aMarkusa/Lab-bench-power-supply/Design files/schematic.pdf

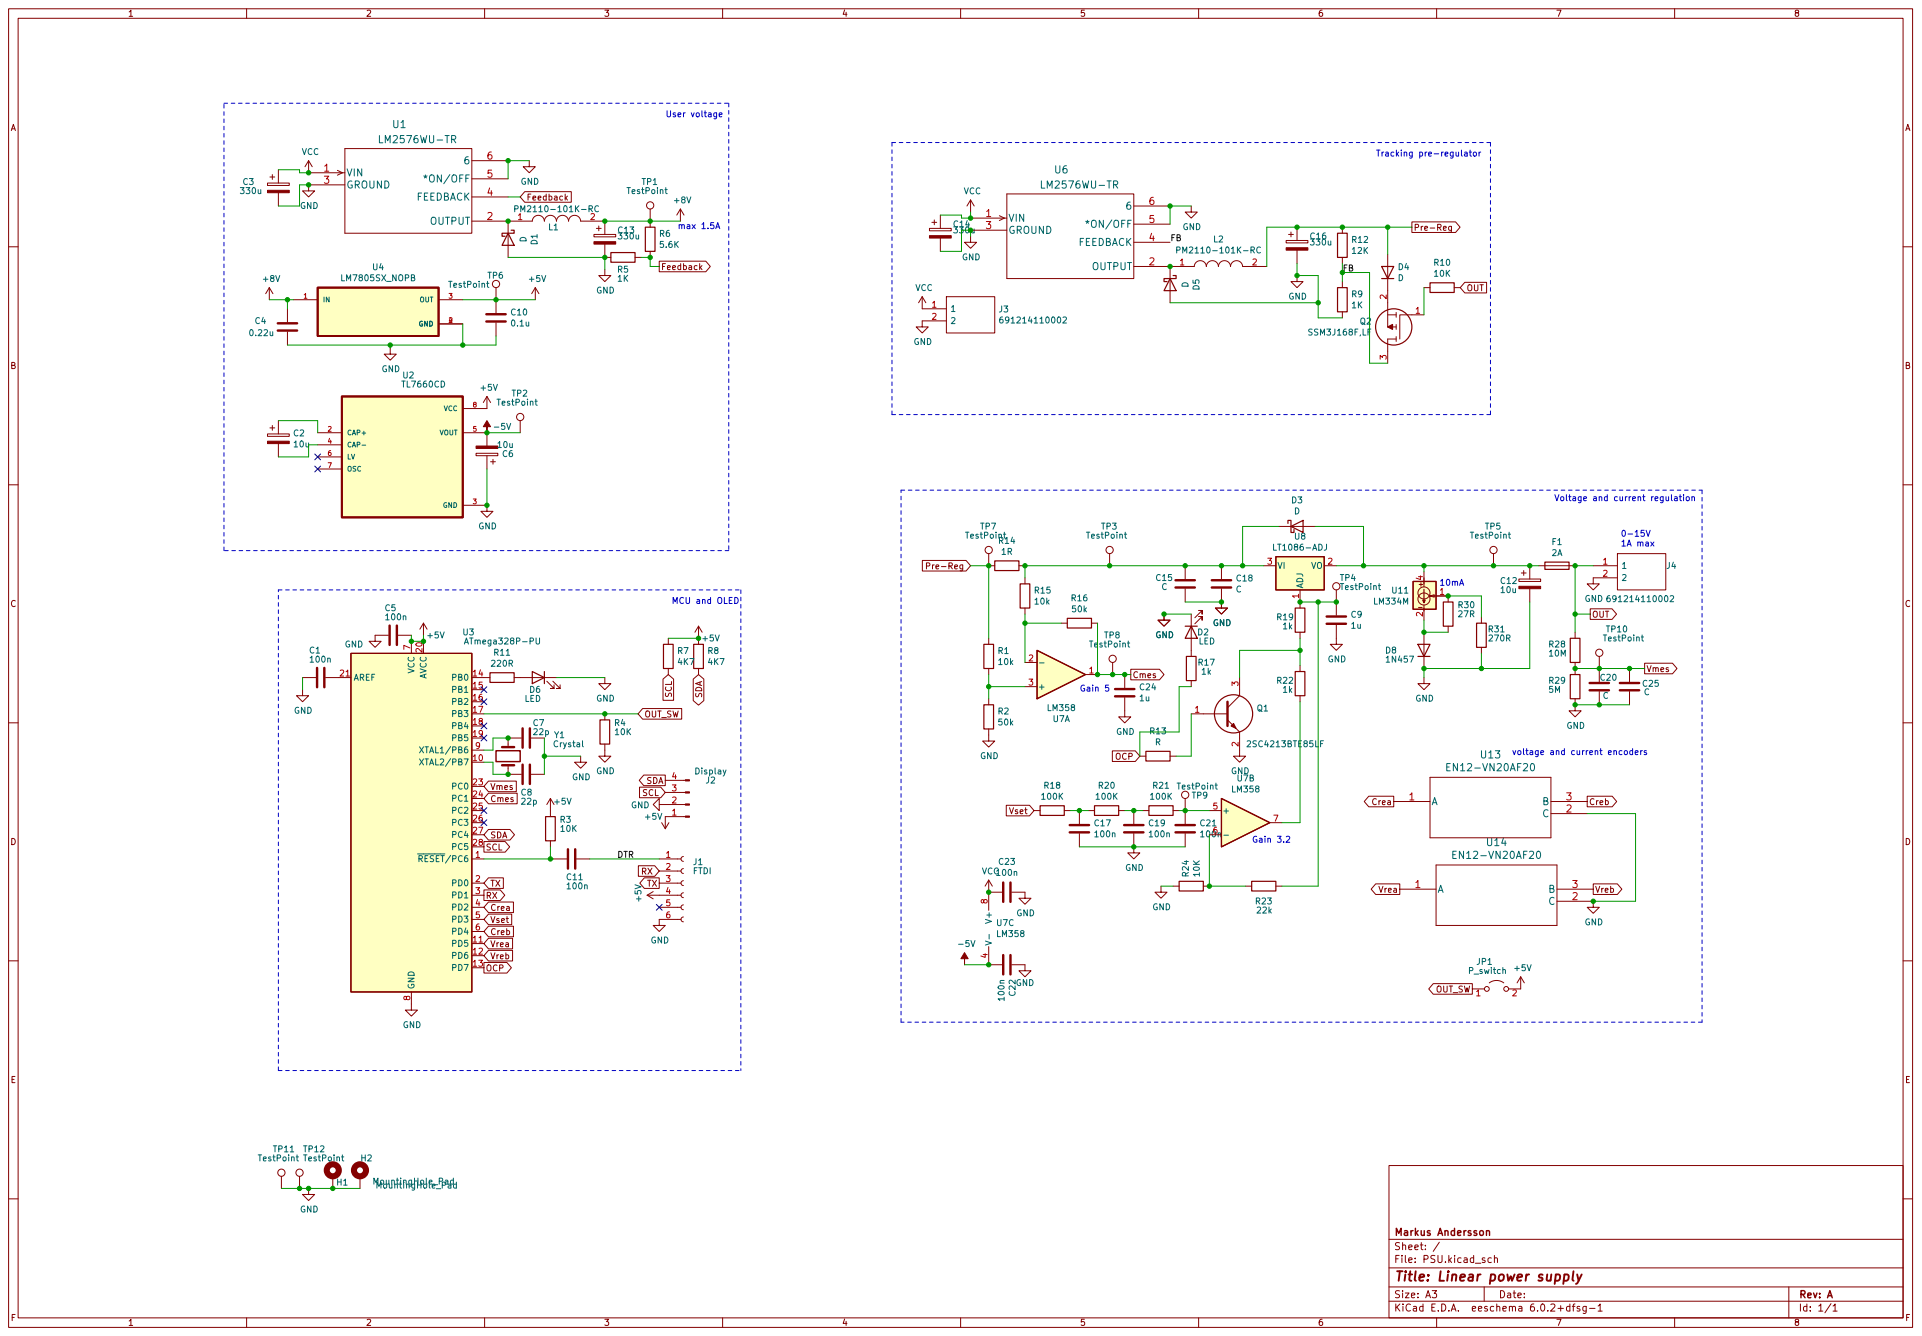
[picture p1: page 1]

max 1.5A User voltage MCU and OLED
691214110002 GND

Tracking pre-regulator Gain 5

Voltage and current regulation Gain 3.2

voltage and current encoders 10mA

File: PSU.kicad_sch Sheet: / Markus Andersson

Id: 1/1 Title: Linear power supply
